Jeff-Conley/business_card_macro/README.md

# business_card_macro
business card that can be used as a macropad
Created by Jeff Conley
