Jeff-Conley/business_card_macro/keypad_case/keypad-Body.stl

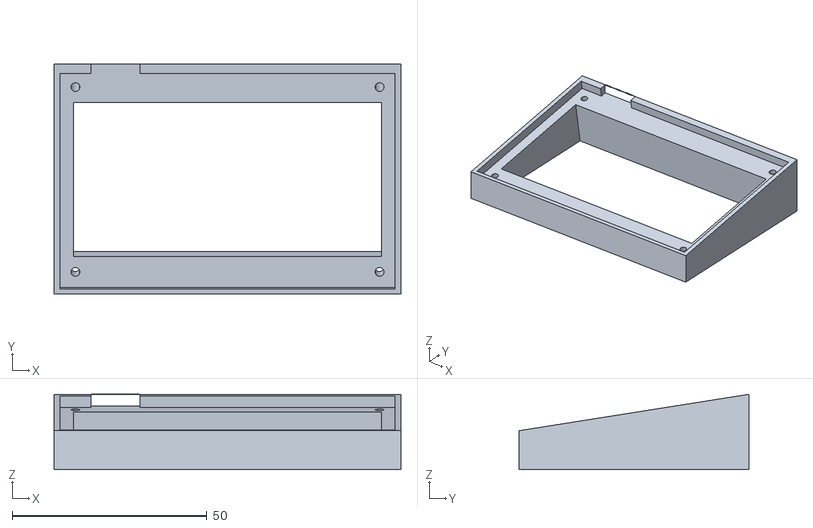
[picture p1: CAD file, 2021-12-31]
keypad_case/keypad-Body.stl
89.0 x 59.0 x 19.3
