Jeff-Conley/business_card_macro/(list of files, cad)

Other CAD files:
keypad_case/keypad.FCStd
