Jeff-Conley/business_card_macro/6_key_macro.kicad_pcb

## KiCad design 6_key_macro.kicad_pcb (2021-12-31)

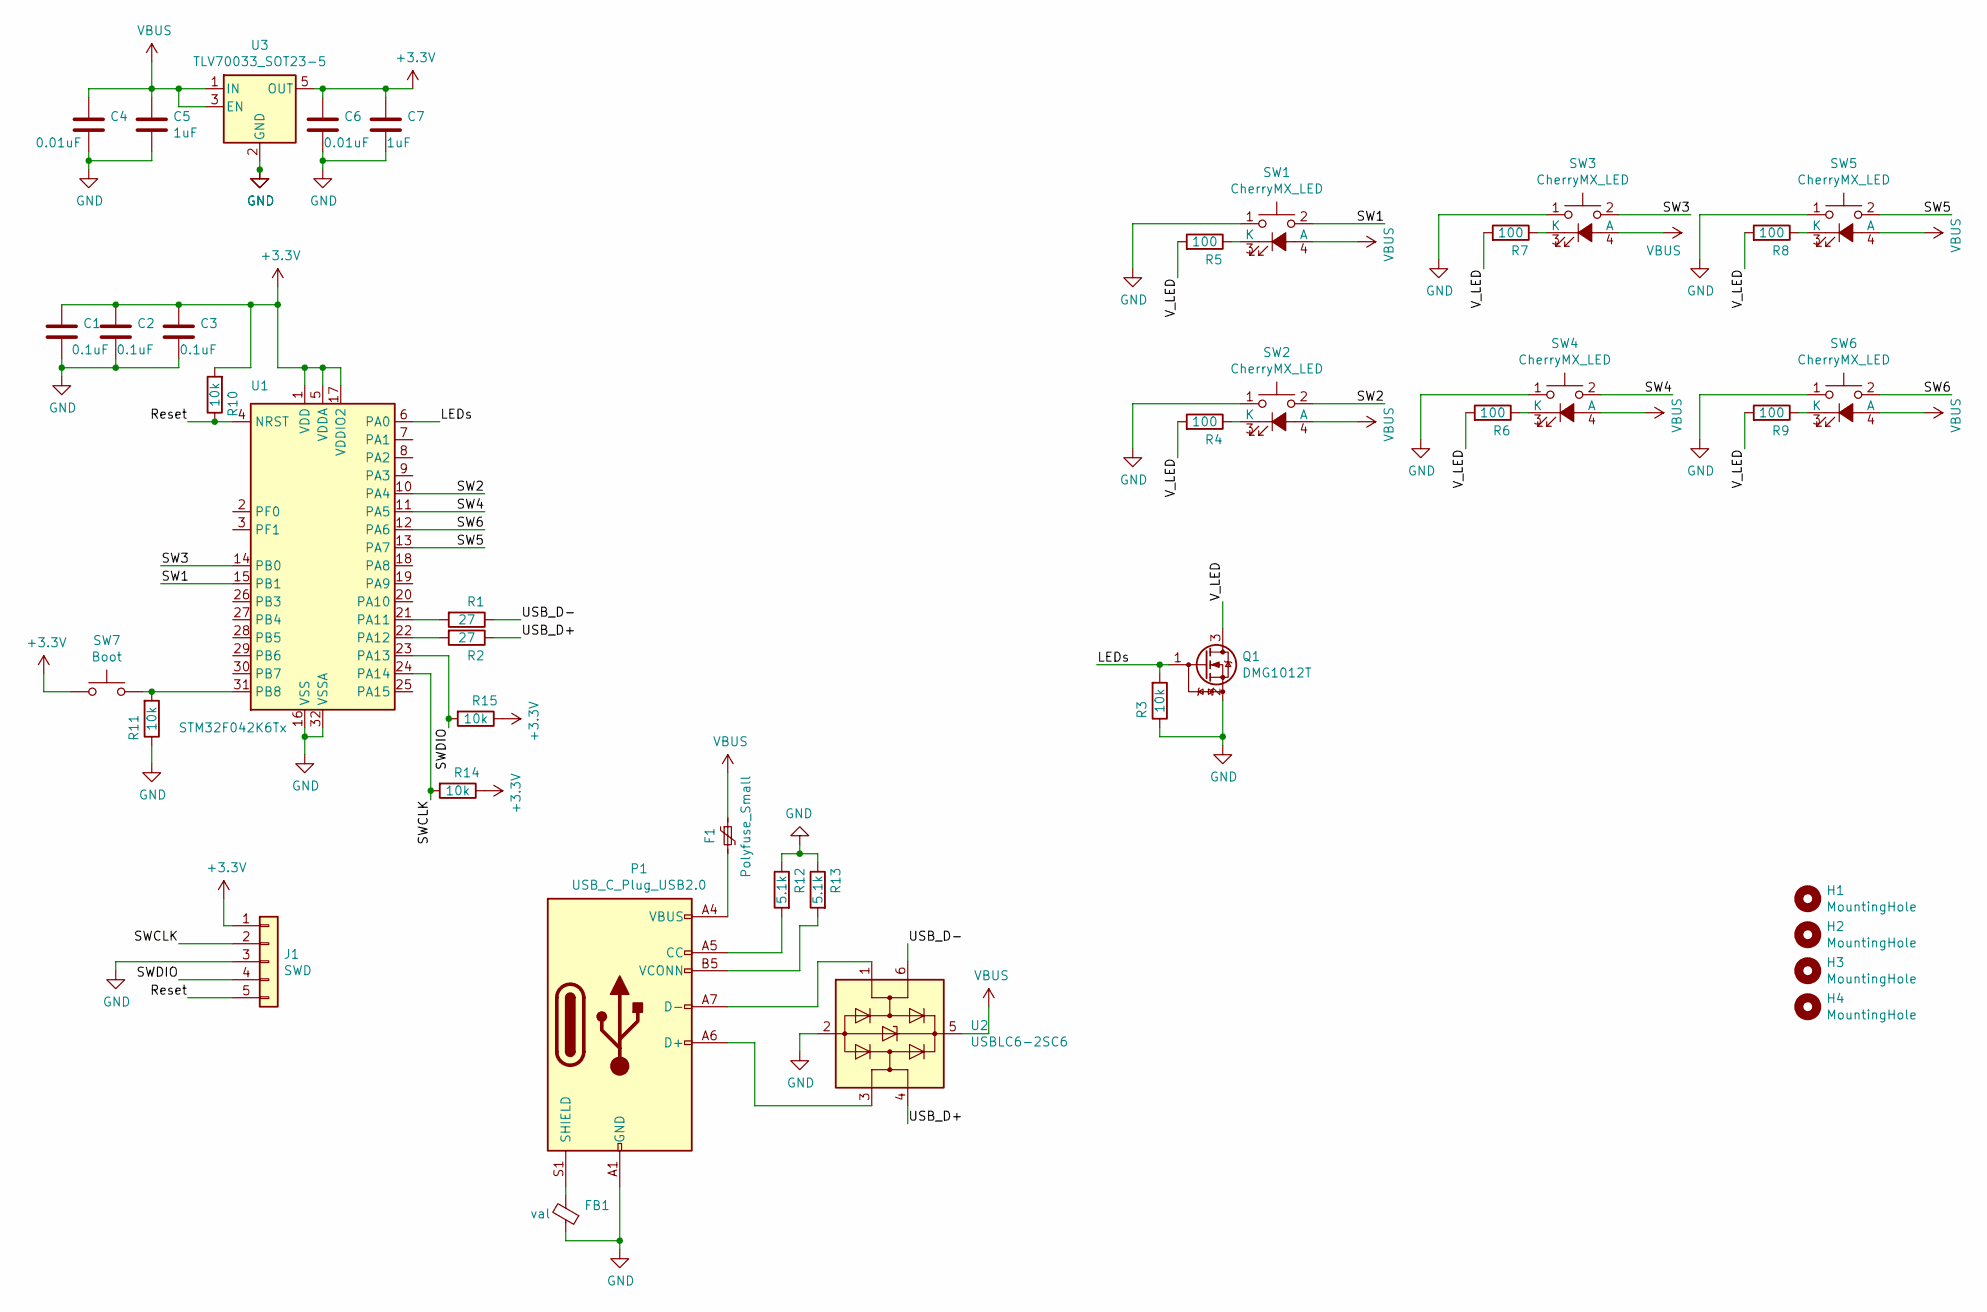
[picture p2: schematic 6_key_macro.kicad_sch, 6key business card]

Parts:
C1, C2, C3: 0.1uF; C_0805_2012Metric_Pad1.18x1.45mm_HandSolder
C4, C6: 0.01uF; C_0805_2012Metric_Pad1.18x1.45mm_HandSolder
C5, C7: 1uF; C_0805_2012Metric_Pad1.18x1.45mm_HandSolder
F1: Polyfuse_Small; Fuse_0805_2012Metric_Pad1.15x1.40mm_HandSolder
FB1: val; L_0805_2012Metric_Pad1.05x1.20mm_HandSolder
H1, H2, H3, H4: MountingHole; MountingHole_3.2mm_M3
J1: SWD; PinHeader_1x05_P2.54mm_Vertical
P1: USB_C_Plug_USB2.0; USB_C_Receptacle_Palconn_UTC16-G
Q1: DMG1012T; SOT-323_SC-70_Handsoldering
R1, R2: 27; R_0805_2012Metric_Pad1.20x1.40mm_HandSolder
R3, R10, R11, R14, R15: 10k; R_0805_2012Metric_Pad1.20x1.40mm_HandSolder
R4, R5, R6, R7, R8, R9: 100; R_0805_2012Metric_Pad1.20x1.40mm_HandSolder
R12, R13: 5.1k; R_0805_2012Metric_Pad1.20x1.40mm_HandSolder
SW1, SW2, SW3, SW4, SW5, SW6: CherryMX_LED; CherryMX_1.00u_PCB_LED
SW7: Boot; SW_PUSH_6mm
U1: STM32F042K6Tx; LQFP-32_7x7mm_P0.8mm
U2: USBLC6-2SC6; SOT-23-6
U3: TLV70033_SOT23-5; SOT-23-5

Connections:
+3V3: C1.1, C2.1, C3.1, C6.1, C7.1, J1.1, R10.2, R14.1, R15.1, SW7.1, U1.1 (VDD), U1.5 (VDDA), U1.17 (VDDIO2), U3.5 (OUT)
/LEDs: Q1.1 (G), R3.2, U1.6 (PA0)
/Reset: J1.5, R10.1, U1.4 (NRST)
/SW1: SW1.2, U1.15 (PB1)
/SW2: SW2.2, U1.10 (PA4)
/SW3: SW3.2, U1.14 (PB0)
/SW4: SW4.2, U1.11 (PA5)
/SW5: SW5.2, U1.13 (PA7)
/SW6: SW6.2, U1.12 (PA6)
/SWCLK: J1.2, R14.2, U1.24 (PA14)
/SWDIO: J1.4, R15.2, U1.23 (PA13)
/USB_D+: R2.1, U2.4 (I/O2)
/USB_D-: R1.1, U2.6 (I/O1)
/V_LED: Q1.3 (D), R4.2, R5.2, R6.2, R7.2, R8.2, R9.2
GND: C1.2, C2.2, C3.2, C4.2, C5.2, C6.2, C7.2, FB1.1, J1.3, P1.A1 (GND), P1.A12 (GND), P1.B1 (GND), P1.B12 (GND), Q1.2 (S), R3.1, R11.1, R12.1, R13.1, SW1.1, SW2.1, SW3.1, SW4.1, SW5.1, SW6.1, U1.16 (VSS), U1.32 (VSSA), U2.2 (GND), U3.2 (GND)
unnamed: F1.2, P1.A4 (VBUS), P1.A9 (VBUS), P1.B4 (VBUS), P1.B9 (VBUS)
unnamed: FB1.2, P1.S1 (SHIELD)
unnamed: P1.A5 (CC), R12.2
unnamed: P1.A6 (D+), U2.3 (I/O2)
unnamed: P1.A7 (D-), U2.1 (I/O1)
unnamed: P1.B5 (VCONN), R13.2
unnamed: R1.2, U1.21 (PA11)
unnamed: R2.2, U1.22 (PA12)
unnamed: R4.1, SW2.3 (K)
unnamed: R5.1, SW1.3 (K)
unnamed: R6.1, SW4.3 (K)
unnamed: R7.1, SW3.3 (K)
unnamed: R8.1, SW5.3 (K)
unnamed: R9.1, SW6.3 (K)
unnamed: R11.2, SW7.2, U1.31 (PB8)
VBUS: C4.1, C5.1, F1.1, SW1.4 (A), SW2.4 (A), SW3.4 (A), SW4.4 (A), SW5.4 (A), SW6.4 (A), U2.5 (VBUS), U3.1 (IN), U3.3 (EN)

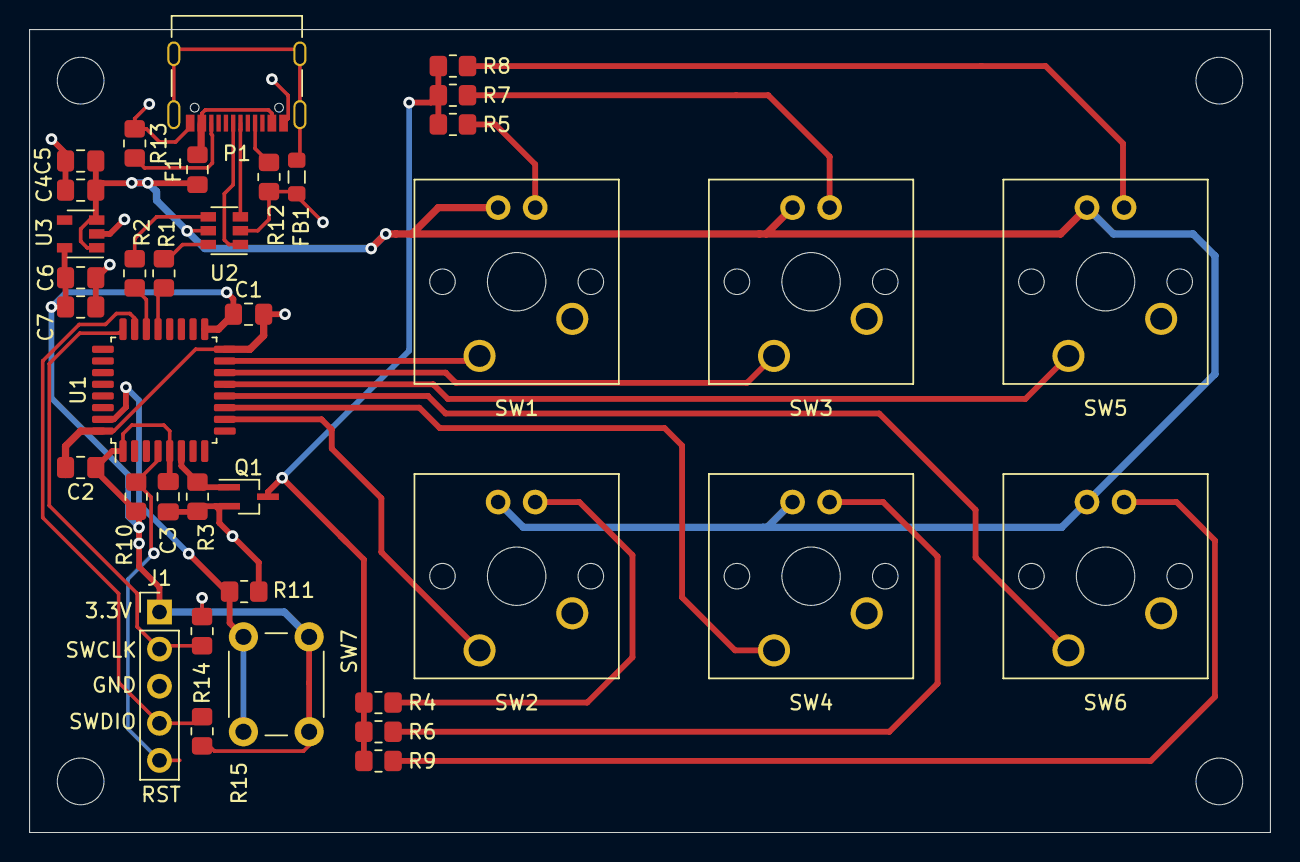
[picture p3: board 6_key_macro.kicad_pcb from above]

Board: 2 copper layers, 85.0 x 55.0 mm, 41 parts (0 on the bottom side), 31 nets.
