Jeff-Conley/business_card_macro/(commit log)

2021-10-24 version 0.2
    [6_key_macro-B_Cu.gbr, 6_key_macro-B_Mask.gbr, 6_key_macro-B_Paste.gbr, 6_key_macro-B_SilkS.gbr, 6_key_macro-Edge_Cuts.gbr, 6_key_macro-F_Cu.gbr, 6_key_macro-F_Mask.gbr, 6_key_macro-F_Paste.gbr]
2021-10-25 added 5.1k resistors to cc1 and cc2 for usb-c to usb-c compatibility
    [6_key_macro.kicad_pcb, 6_key_macro.sch]
2021-10-26 swapped tvs diodes
    [6_key_macro.kicad_pcb, 6_key_macro.sch]
2021-11-10 moved files to top level. Decided to move firmware to separate repo
    [6_key_macro-B_Cu.gbr, 6_key_macro-B_Mask.gbr, 6_key_macro-B_Paste.gbr, 6_key_macro-B_SilkS.gbr, 6_key_macro-Edge_Cuts.gbr, 6_key_macro-F_Cu.gbr, 6_key_macro-F_Mask.gbr, 6_key_macro-F_Paste.gbr]
2021-11-14 added files for 3d printed case
    [keypad-Body.stl, keypad.FCStd]
2021-12-31 update case design
    [keypad-Body.stl, keypad.FCStd]
2021-12-31 update files to kicad V6
    [6_key_macro.kicad_pcb, 6_key_macro.kicad_sch]
